parallellogic-/MalO_SAO/doc/spec_sheets/DEFCON34_SAO_MICD.pdf

# DC34 Badge SAO Electrical Spec

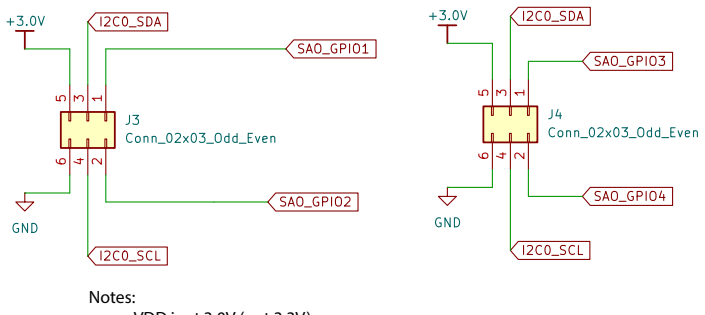
[picture p3: figure]
Notes:

# DC34 Badge SAO Mechanical Spec

- VDD is at 3.0V (not 3.3V)
- Supply tested to 100mA total across both SAOs
(supply can do “more”, but no promises)
- The badge is powered o of 2xAA batteries
- There is a USB type C port. When powered o a power bank, the badge stays continuously on
- GPIO4 is an open-drain wake-up interrupt to the CPU
- Other GPIOs have some combination of pull-up or pull-down resistors on them ranging from 2.2k to ~47k
- I2C has devices on 0x3C and 0x19

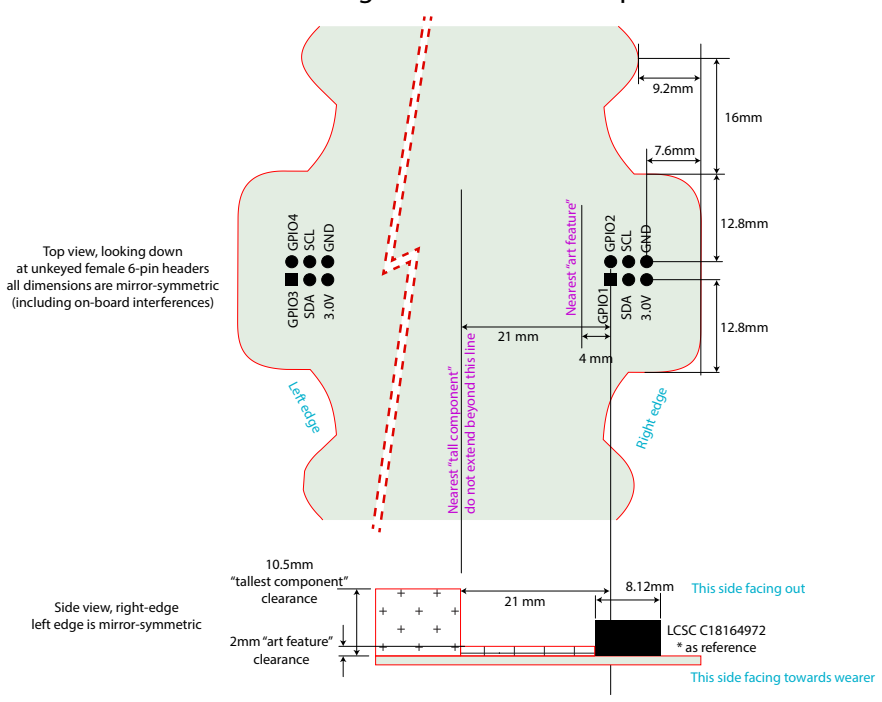
[picture p4: figure]
SCL; GND; SDA; GPIO3 GPIO4; GPIO1; GPIO2; Right edge; Left edge; Top view, looking down at unkeyed female 6-pin headers all dimensions are mirror-symmetric (including on-board interferences); Nearest “art feature”; Nearest “tall component”; do not extend beyond this line; Side view, right-edge; left edge is mirror-symmetric; LCSC C18164972; * as reference 2mm “art feature”; clearance; 10.5mm “tallest component” clearance; This side facing out; This side facing towards wearer
