parallellogic-/MalO_SAO/doc/header.png

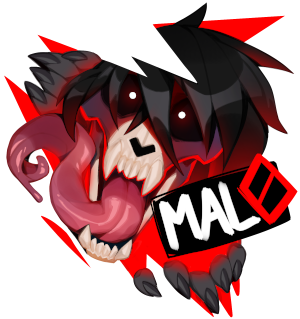
doc/header.png
