parallellogic-/MalO_SAO/doc/r2/layout_bottom.png

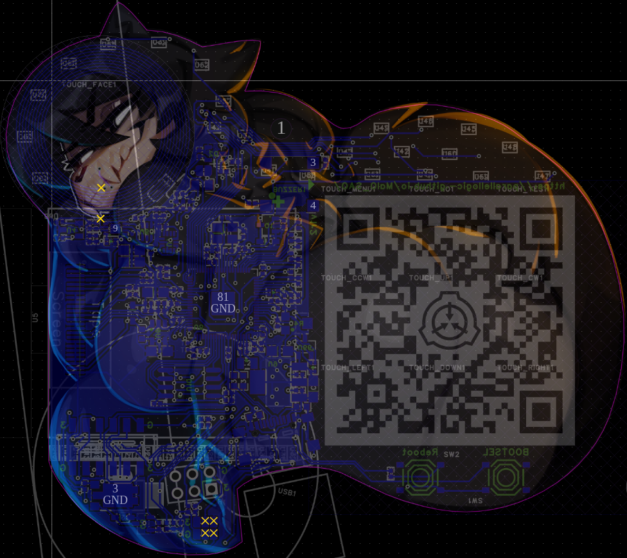
doc/r2/layout_bottom.png
