parallellogic-/MalO_SAO/doc/r2/layout_top.png

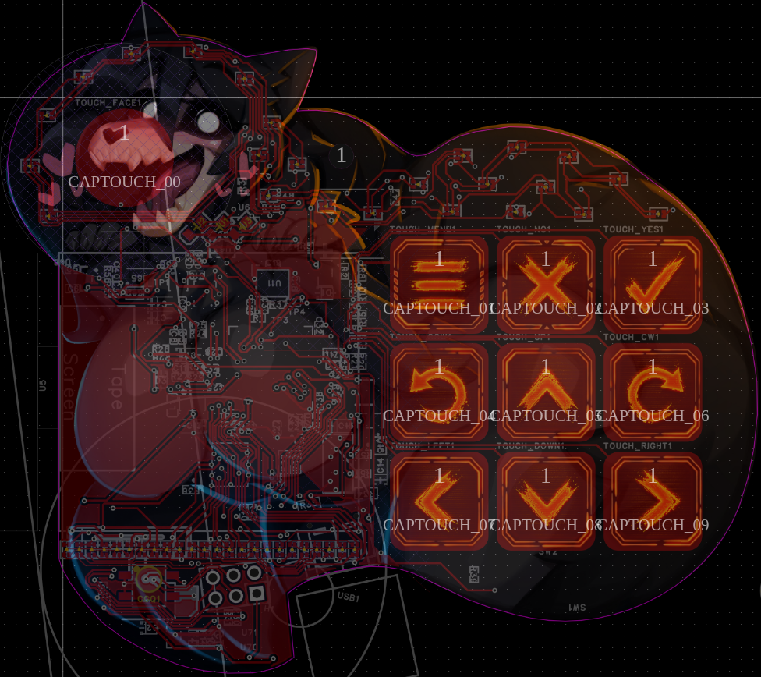
doc/r2/layout_top.png
