parallellogic-/MalO_SAO/doc/r2/render_back_ransparent.png

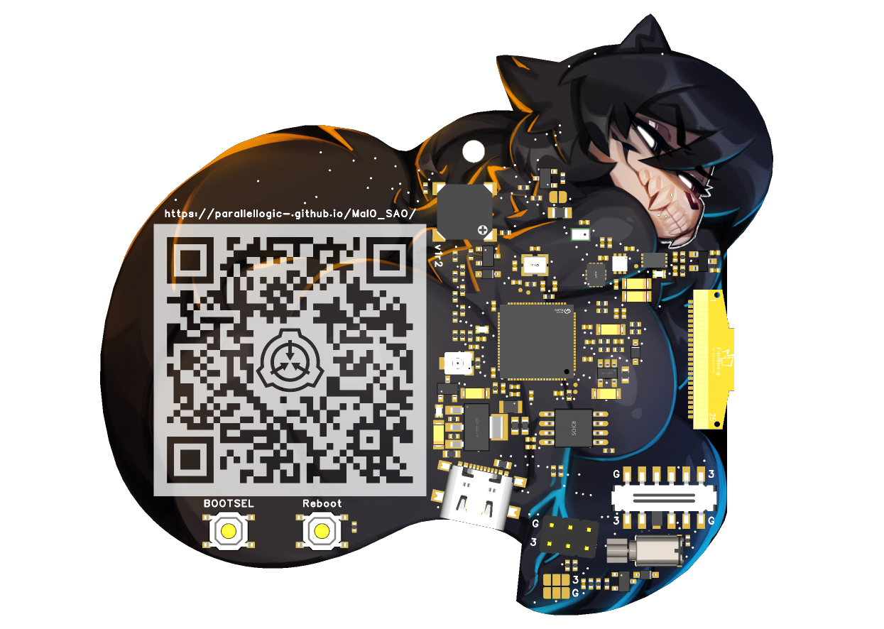
doc/r2/render_back_ransparent.png
