parallellogic-/MalO_SAO/doc/r2/render_front_dims.png

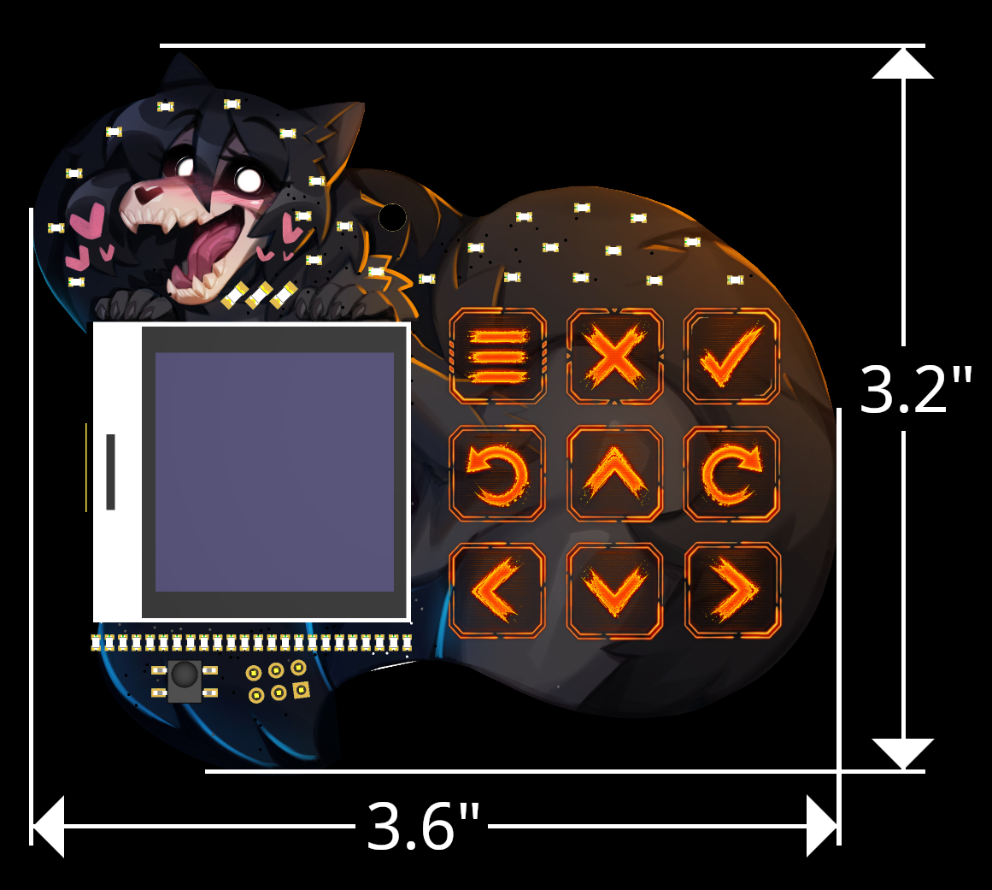
doc/r2/render_front_dims.png
