parallellogic-/MalO_SAO/doc/r2/render_front_transparent.png

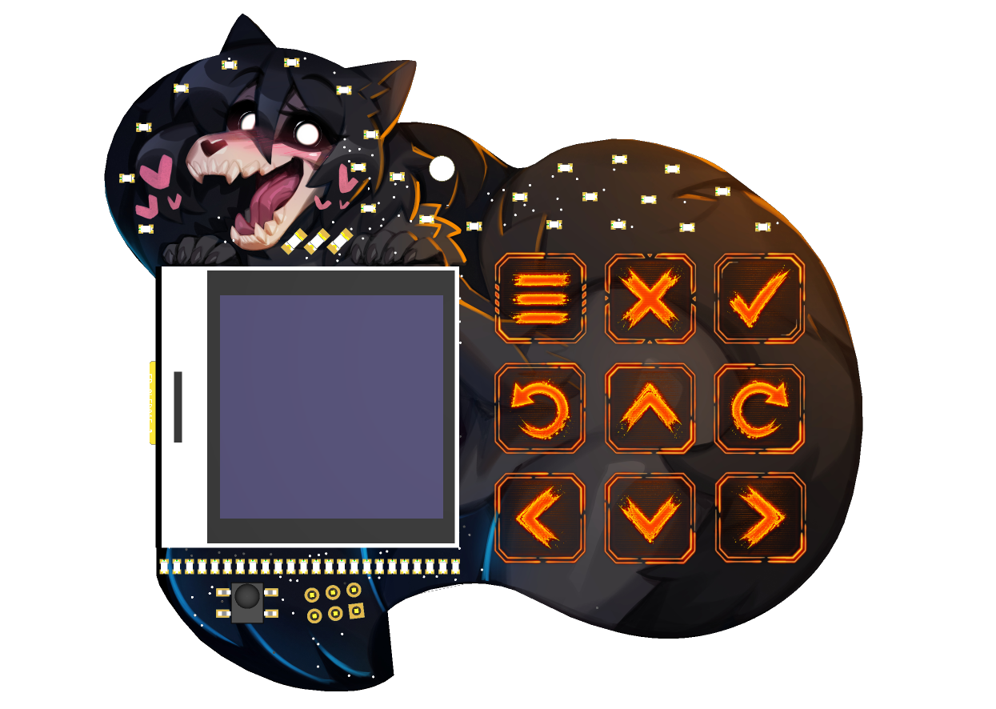
doc/r2/render_front_transparent.png
