parallellogic-/MalO_SAO/doc/r2/render_side.png

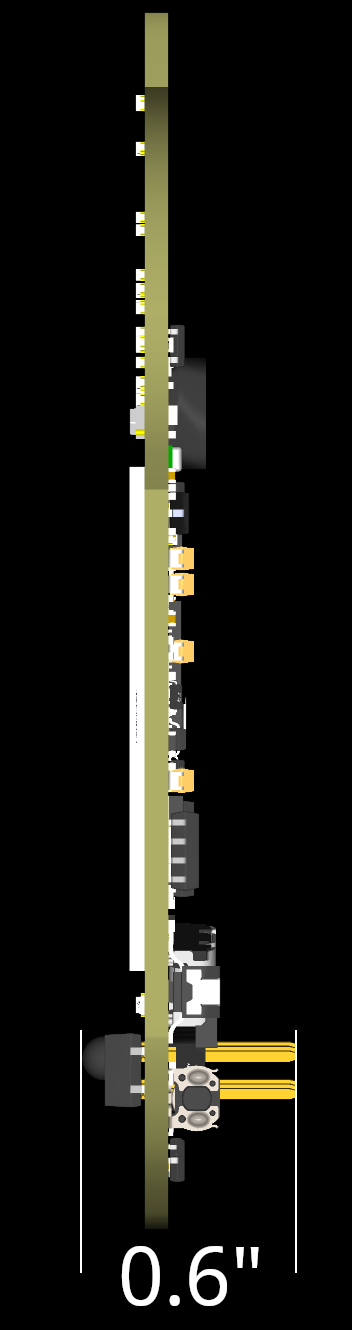
doc/r2/render_side.png
