parallellogic-/MalO_SAO/img/r1/art_outline.jpg

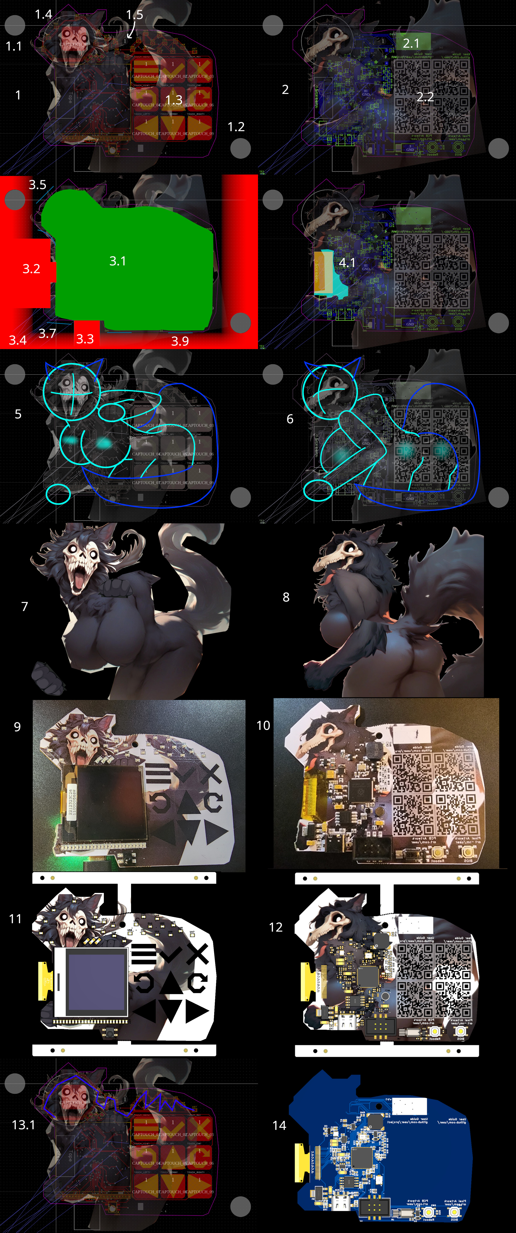
img/r1/art_outline.jpg
