parallellogic-/MalO_SAO/img/r1/front.png

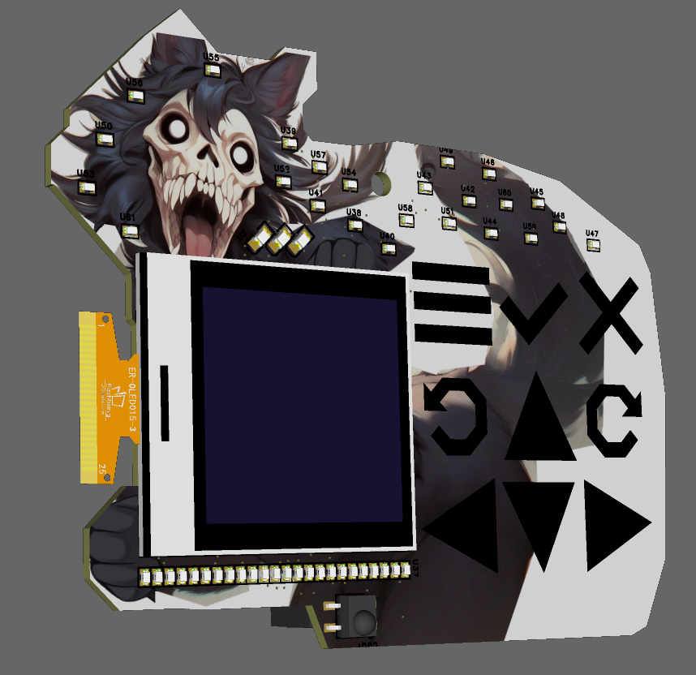
img/r1/front.png
