parallellogic-/MalO_SAO/img/r1/rear.png

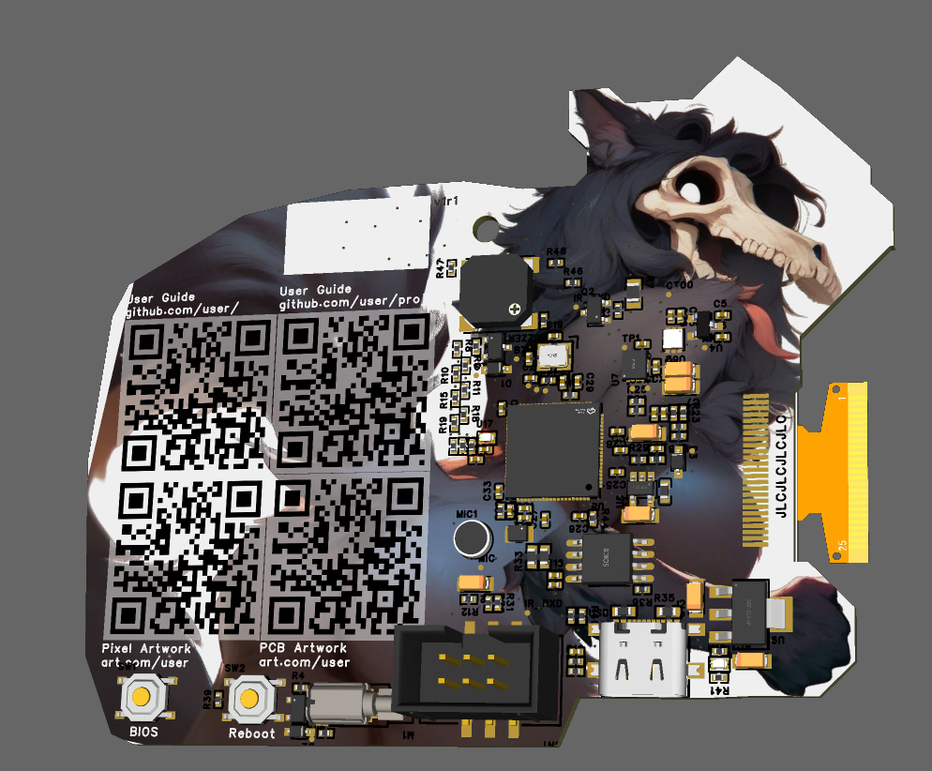
img/r1/rear.png
