parallellogic-/MalO_SAO/img/r1/Screenshot from 2026-04-02 22-24-46.png

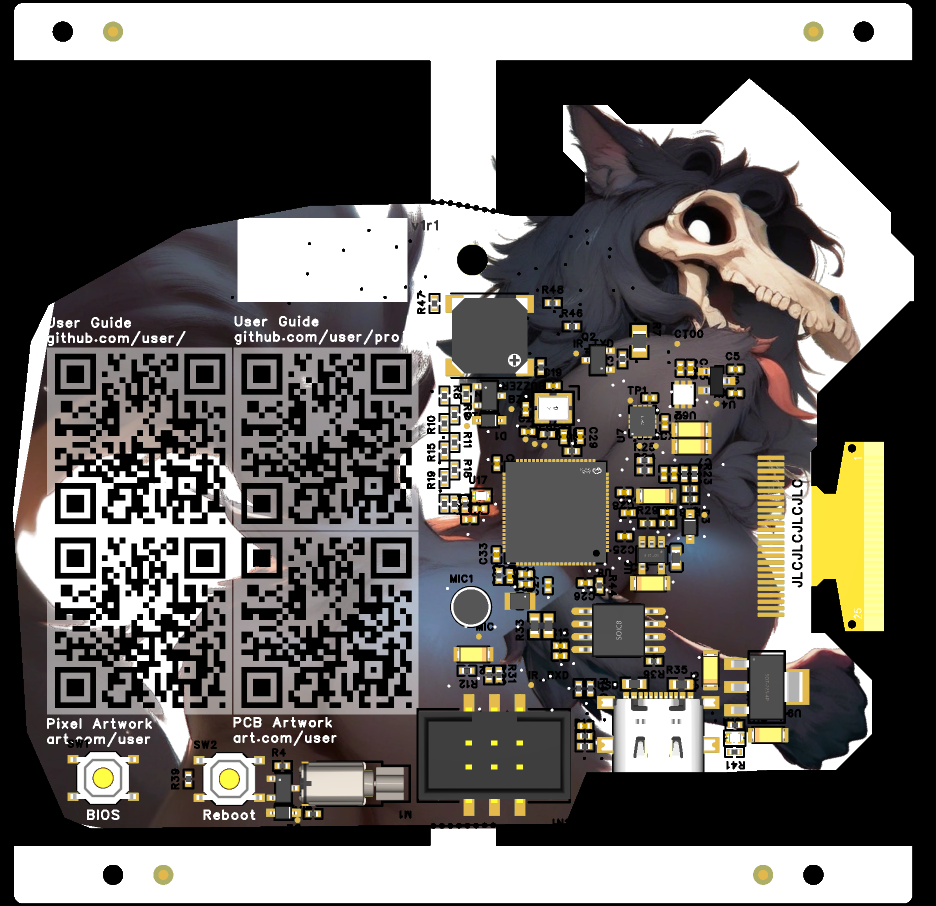
img/r1/Screenshot from 2026-04-02 22-24-46.png
