parallellogic-/MalO_SAO/img/r1/Screenshot from 2026-04-02 22-28-03.png

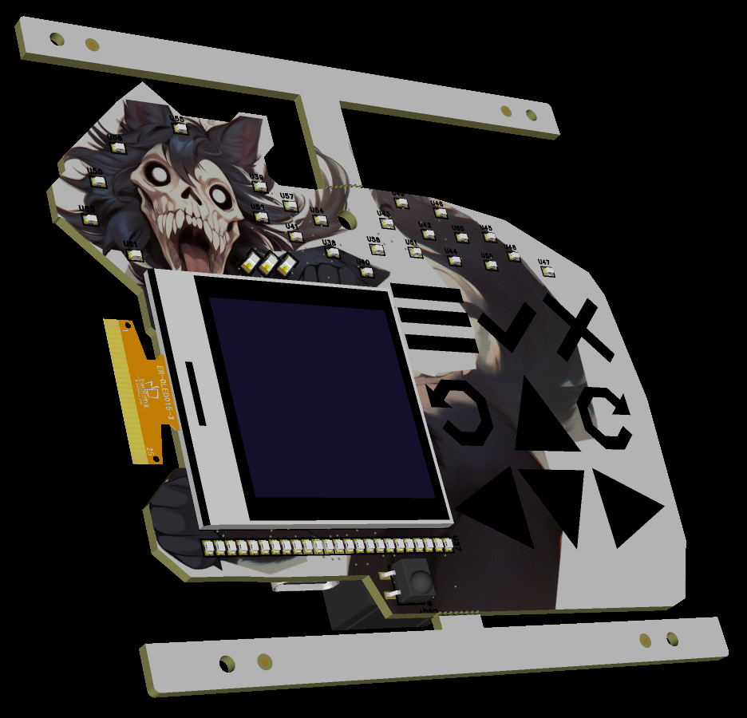
img/r1/Screenshot from 2026-04-02 22-28-03.png
