parallellogic-/MalO_SAO/img/r2/back_hotglewd.jpg

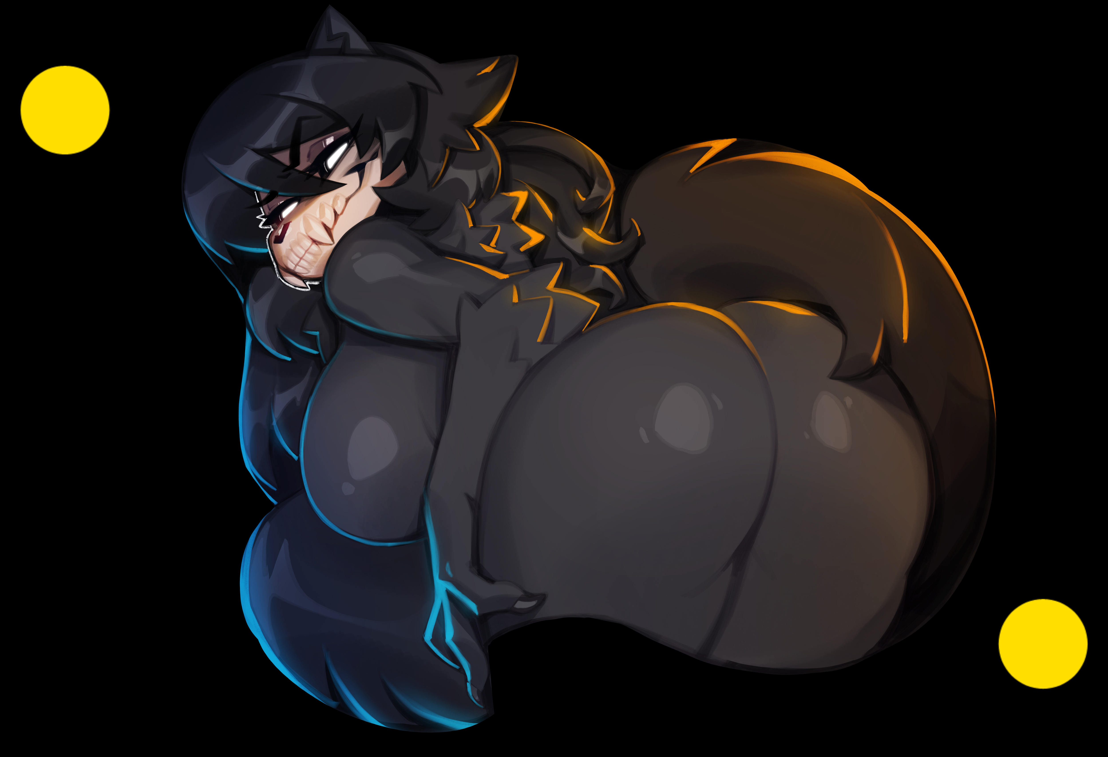
img/r2/back_hotglewd.jpg
