parallellogic-/MalO_SAO/img/r2/back_hotglewd_merged.jpg

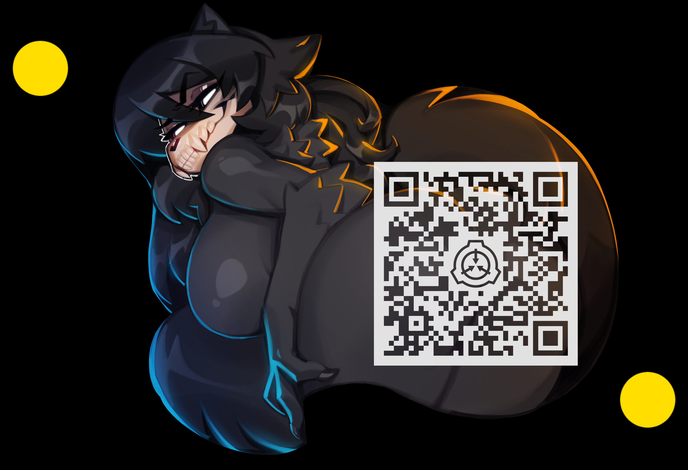
img/r2/back_hotglewd_merged.jpg
