parallellogic-/MalO_SAO/img/r2/buttons.png

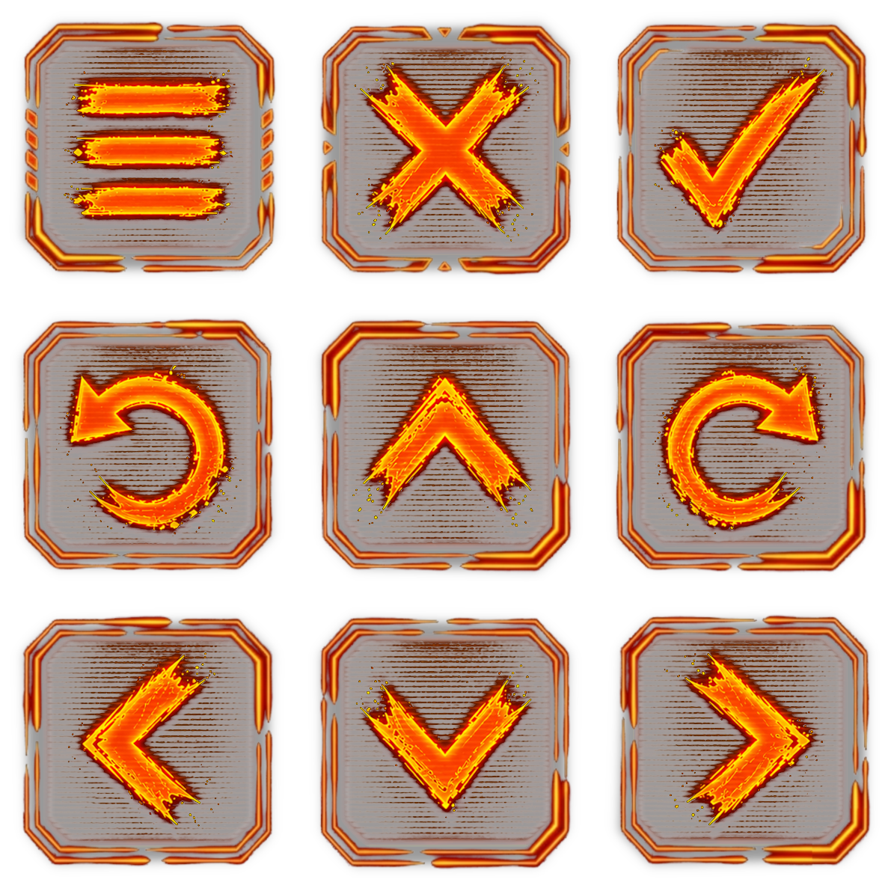
img/r2/buttons.png
