parallellogic-/MalO_SAO/img/r2/front_hotglewd.jpg

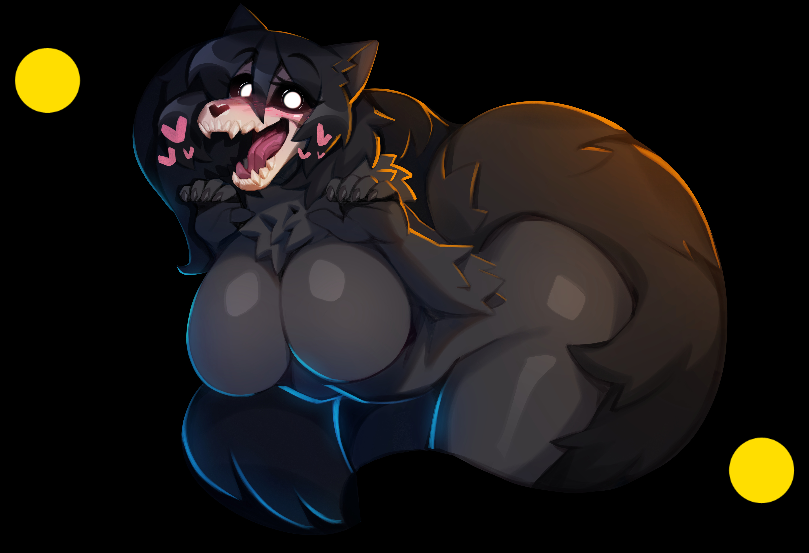
img/r2/front_hotglewd.jpg
