parallellogic-/MalO_SAO/img/stickers/back_hotglewd_merged_v3.jpg

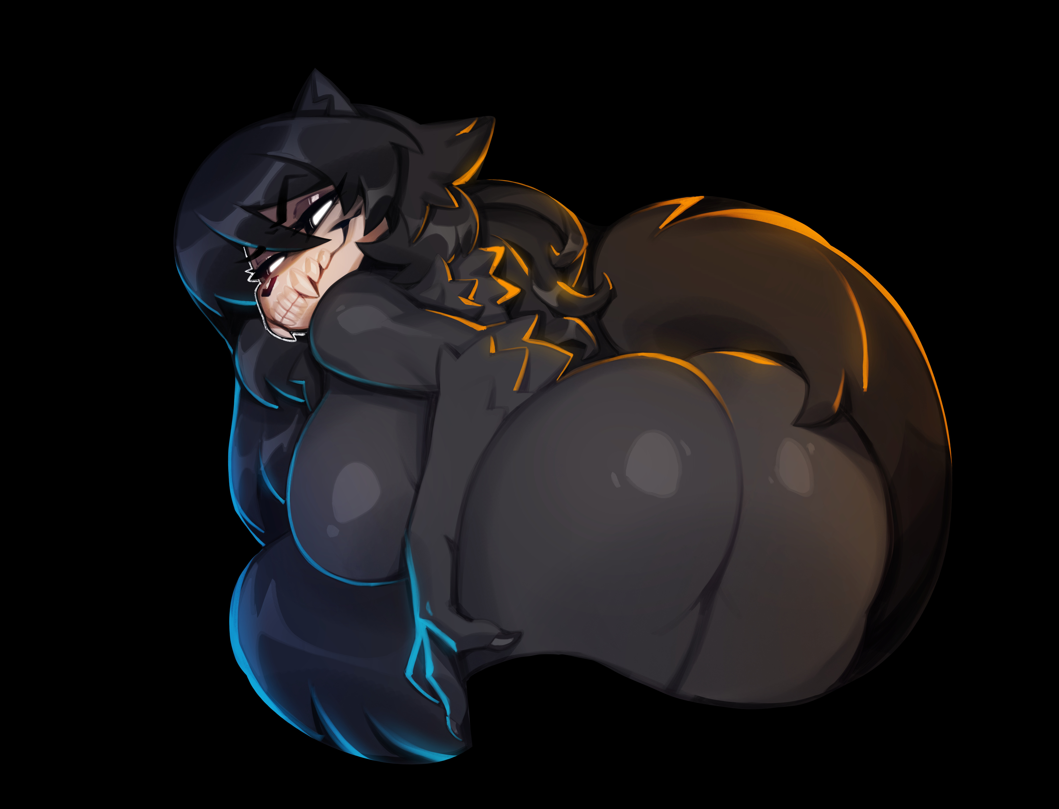
img/stickers/back_hotglewd_merged_v3.jpg
