parallellogic-/MalO_SAO/img/stickers/front_hotglewd_merged_v3.jpg

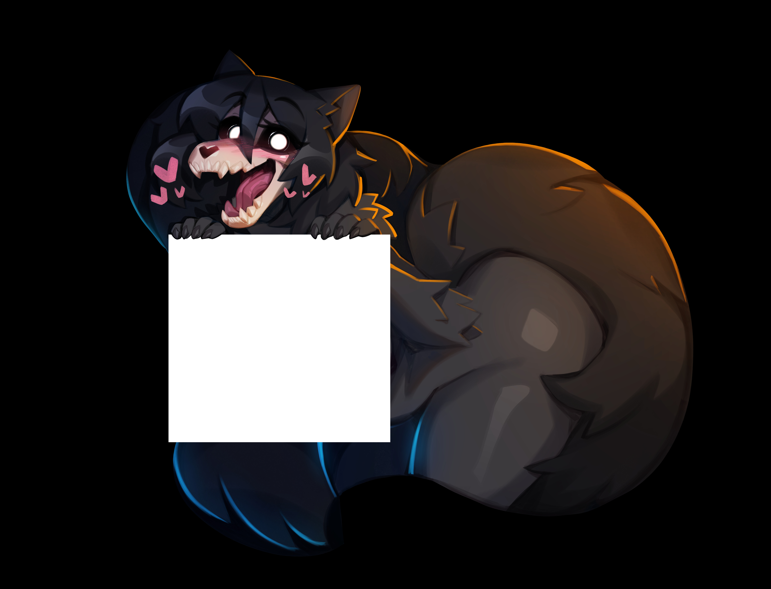
img/stickers/front_hotglewd_merged_v3.jpg
