parallellogic-/MalO_SAO/fab/r3/BOM_Board1_PCB1_2026-06-30.csv

No. | Quantity | Comment | Designator | Footprint | Value | Manufacturer Part | Manufacturer | Supplier Part | Supplier
1 | 1 | 2.7kHz | BUZZER1 | BUZ-SMD_4P-L7.5-W7.5-P7.59-TL | 2.7kHz | MLT-7525 | 华能 | C95299 | LCSC
2 | 1 | 2.2uF | C1 | C0402 | 2.2uF | CL05A225KP5NSNC | SAMSUNG(三星) | C107369 | LCSC
3 | 11 | 100nF | C3,C5,C6,C8,C9,C10,C11,C16,C35,C37,C38 | C0402 | 100nF | CL05B104KB54PNC | SAMSUNG(三星) | C307331 | LCSC
4 | 5 | 10uF | C4,C7,C12,C13,C14 | CASE-A_3216 | 10uF | CA45-A010K106T | 湘怡中元/湘江 | C119052 | LCSC
5 | 1 | 22uF | C15 | CASE-A_3216 | 22uF | CA45-A-10V-22uF-K | CEC(振华新云) | C129272 | LCSC
6 | 2 | 4.7uF | C17,C36 | C0402 | 4.7uF | CL05A475KP5NRNC | SAMSUNG(三星) | C368809 | LCSC
7 | 2 | 15pF | C18,C19 | C0402 | 15pF | 0402CG150J500NT | FH(风华) | C1548 | LCSC
8 | 4 | 4.7uF | C20,C21,C22,C34 | C0402 | 4.7uF | CL05A475MP5NRNC | SAMSUNG(三星) | C23733 | LCSC
9 | 11 | 100nF | C23,C24,C25,C26,C27,C28,C29,C30,C31,C32,C33 | C0402 | 100nF | CL05A104KA5NNNC | SAMSUNG(三星) | C100072 | LCSC
10 | 2 | 22pF | C39,C40 | C0402 | 22pF | 0402CG220F500NT | FH(风华) | C190090 | LCSC
11 | 1 | IRM-H638T/TR2 | CGQ1 | SENSOR-SMD_IRM-H638T-TR2-TL |  | IRM-H638T/TR2 | EVERLIGHT(亿光) | C91447 | LCSC
12 | 3 | 1N5819WS | D1,D2,D3 | SOD-323_L1.8-W1.3-LS2.5-RD |  | 1N5819WS | Hottech(合科泰) | C191023 | LCSC
13 | 1 | PZ254V-12-6P | H1 | HDR-TH_6P-P2.54-V-M-R2-C3-S2.54 |  | PZ254V-12-6P | XFCN(兴飞) | C492420 | LCSC
14 | 1 | 10uH | L1 | L0603 | 10uH | SDFL1608S100KTF | Sunlord(顺络) | C1035 | LCSC
15 | 1 | 3.3uH | L2 | IND-SMD_L2.0-W1.6_AOTA-B201610S3R3-101-T | 3.3uH | AOTA-B201610S3R3-101-T | ABRACON | C42411119 | LCSC
16 | 1 | Z3OC1T8219731 | M1 | VIBRATING-MOTOR-SMD_3P-C9900001680 |  | Z3OC1T8219731 | KOTL(金龙机电) | C2894731 | LCSC
17 | 3 | L2N7002SLLT1G | Q1,Q2,Q3 | SOT-23-3_L3.0-W1.7-P0.95-LS2.9-BR |  | L2N7002SLLT1G | LRC(乐山无线电) | C22446827 | LCSC
18 | 10 | 1MΩ | R1,R8,R9,R10,R11,R15,R18,R19,R20,R21 | R0402 | 1MΩ | FRC0402F1004TS | FOJAN(富捷) | C2909328 | LCSC
19 | 7 | 10kΩ | R2,R3,R4,R28,R29,R52,R53 | R0402 | 10kΩ | FRC0402J103 TS | FOJAN(富捷) | C2906885 | LCSC
20 | 1 | 0Ω | R5 | R0402 | 0Ω | FRC0402P000 TS | FOJAN(富捷) | C2906877 | LCSC
21 | 1 | 5.1Ω | R6 | R0402 | 5.1Ω | FRC0402F5R10TS | FOJAN(富捷) | C2909363 | LCSC
22 | 1 | 22Ω | R7 | R0805 | 22Ω | AC0805FR-7W22RL | YAGEO(国巨) | C6492135 | LCSC
23 | 1 | 200Ω | R14 | R0402 | 200Ω | FRC0402F2000TS | FOJAN(富捷) | C2909333 | LCSC
24 | 2 | 2.2kΩ | R24,R25 | R0402 | 2.2kΩ | FRC0402J222 TS | FOJAN(富捷) | C2906920 | LCSC
25 | 1 | 1MΩ | R26 | R0402 | 1MΩ | 0402WGF1004TCE | UNI-ROYAL(厚声) | C26083 | LCSC
26 | 1 | 100kΩ | R27 | R0402 | 100kΩ | FRC0402J104 TS | FOJAN(富捷) | C2906883 | LCSC
27 | 5 | 1kΩ | R30,R31,R36,R37,R39 | R0402 | 1kΩ | FRC0402F1001TS | FOJAN(富捷) | C2906864 | LCSC
28 | 2 | 27Ω | R32,R33 | R0603 | 27Ω | 0603WAF270JT5E | UNI-ROYAL(厚声) | C25190 | LCSC
29 | 2 | 5.1kΩ | R34,R35 | R0603 | 5.1kΩ | FRC0603F5101TS | FOJAN(富捷) | C2907044 | LCSC
30 | 1 | 33Ω | R38 | R0402 | 33Ω | FRC0402F33R0TS | FOJAN(富捷) | C2906868 | LCSC
31 | 7 | 36Ω | R40,R43,R44,R45,R46,R47,R48 | R0402 | 36Ω | FRC0402F36R0TS | FOJAN(富捷) | C2998152 | LCSC
32 | 1 | 10kΩ | R49 | RES-ADJ-SMD_3P-L3.0-W3.8-P1.75-BR | 10kΩ | TC33X-2-103E | BOURNS | C719176 | LCSC
33 | 1 | 2kΩ | R51 | R0402 | 2kΩ | FRC0402F2001TS | FOJAN(富捷) | C2909344 | LCSC
34 | 2 | 6.2Ω | R55,R56 | R0402 | 6.2Ω | GR0402F6R2TAG00 | GiantOhm(鼎声微电) | C49654638 | LCSC
35 | 2 | TS-1187A-B-A-B | SW1,SW2 | SW-SMD_4P-L5.1-W5.1-P3.70-LS6.5-TL_H1.5 |  | TS-1187A-B-A-B | XKB Connection(中国星坤) | C318884 | LCSC
36 | 1 | K3-2268S-F1 | SW3 | SW-TH_K3-2268S-F1 |  | K3-2268S-F1 | 韩国韩荣 | C223866 | LCSC
37 | 10 | Test-Point | TOUCH_CCW1,TOUCH_CW1,TOUCH_DOWN1,TOUCH_FACE1,TOUCH_LEFT1,TOUCH_MENU1,TOUCH_NO1,TOUCH_RIGHT1,TOUCH_UP1,TOUCH_YES1 | touch_12mm
38 | 5 | Test-Point | TP1,TP3,TP4,TP5,TP6 | Test-Point-0.5mm
39 | 3 | XL-2012IRC-940 | U1,U2,U3 | LED0805-RD |  | XL-2012IRC-940 | XINGLIGHT(成兴光) | C965889 | LCSC
40 | 1 | HAL403SO | U4 | SOT-23-3_L2.9-W1.3-P1.90-LS2.4-BR-CW |  | HAL403SO | Hallwee(霍尔微电子) | C42387470 | LCSC
41 | 1 | SSD1327_128x128 | U5 | ssd1327_128x128
42 | 1 | MT3540-F23 | U6 | SOT-23-5_L3.0-W1.7-P0.95-LS2.8-BR |  | MT3540-F23 | 西安航天民芯 | C181783 | LCSC
43 | 1 | LSM6DS3TR | U7 | LGA-14_L3.0-W2.5-P0.50-TL |  | LSM6DS3TR | ST(意法半导体) | C95230 | LCSC
44 | 1 | RP2350B | U8 | QFN-80_L10.0-W10.0-P0.40-TL-EP3.4 |  | RP2350B | Raspberry Pi(树莓派) | C42415655 | LCSC
45 | 1 | LD1117-3.3 | U9 | SOT-223_L6.7-W3.5-P2.30-BR |  | LD1117-3.3 | UMW(友台半导体) | C347229 | LCSC
46 | 1 | W25Q128JVSIQ | U10 | SOIC-8_L5.3-W5.3-P1.27-LS8.0-BL |  | W25Q128JVSIQ | Winbond(华邦) | C113767 | LCSC
47 | 1 | ABM8-272-T3 | U11 | SMD3225-4P_SMD3225-4P |  | ABM8-272-T3 | ABRACON | C20625731 | LCSC
48 | 51 | XL-1608SURUGC | U12,U13,U14,U15,U16,U17,U18,U19,U20,U21,U22,U23,U24,U25,U26,U27,U28,U29,U30,U31,U32,U33,U34,U35,U36,U37,U38,U39,U40,U41,U42,U43,U44,U45,U46,U47,U48,U49,U50,U51,U52,U53,U54,U55,U56,U57,U58,U59,U60,U61,U69 | LED-SMD_4P-L1.6-W0.8-RD_1 |  | XL-1608SURUGC | XINGLIGHT(成兴光) | C5349934 | LCSC
49 | 1 | LTR-308ALS-01 | U62 | SENSOR-SMD_6P-L2.0-W2.0-P0.65-BL |  | LTR-308ALS-01 | LITEON(光宝) | C492382 | LCSC
50 | 1 | LMD2718T261-OA1 | U63 | MIC-SMD_6P-L2.8-W1.9-P0.98-TL |  | LMD2718T261-OA1 | LinkMems(聆麦声学) | C5373237 | LCSC
51 | 1 | 13.56MHz | U65 | UFDFN-8_L3.0-W2.0-P0.50-TL-EP1.4 | 13.56MHz | ST25DV04K-IER6C3 | ST(意法半导体) | C2908287 | LCSC
52 | 1 | LM385DBZ-1.2RG | U66 | SOT-23-3_L2.9-W1.6-P1.90-LS2.8-BR |  | LM385DBZ-1.2RG | HGC(深圳汉芯) | C5145284 | LCSC
53 | 1 | TYPE-C 16P QTWT | USB1 | USB-TYPE-C-SMD_TYPE-C-16P-QTWT |  | TYPE-C 16P QTWT | SHOU HAN(首韩) | C5187472 | LCSC
