parallellogic-/MalO_SAO/fab/assembly/malo_2-PartChamfer004d.step

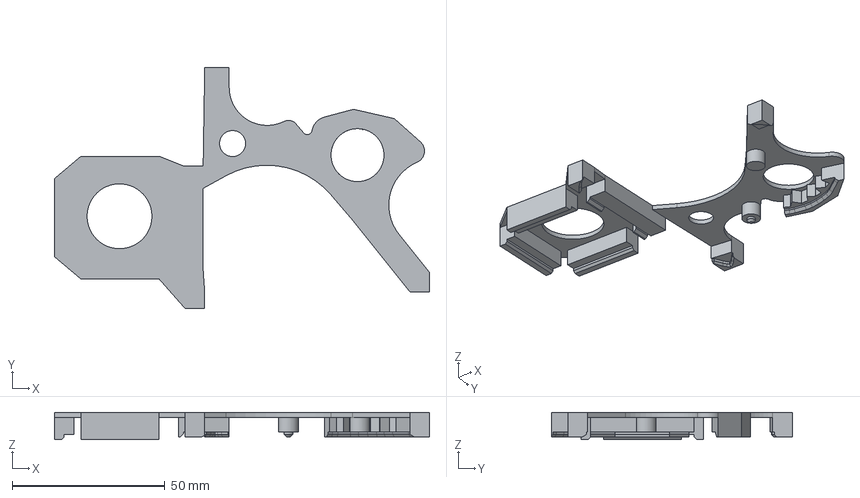
[picture p25: CAD file, 2026-07-25]
fab/assembly/malo_2-PartChamfer004d.step
122.8 x 78.8 x 8.90 mm
