parallellogic-/MalO_SAO/img/r2/outline_v3.dxf

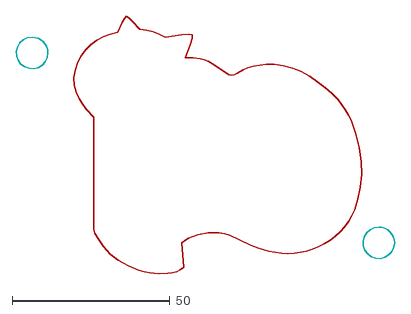
[picture p26: CAD file, 2026-06-13]
img/r2/outline_v3.dxf
120.0 x 81.6
