parallellogic-/MalO_SAO/pcb/NFC_27x27_N10_ST_ST25DV_export/NFC_26x26_N10_ST_ST25DV_geometry.dxf

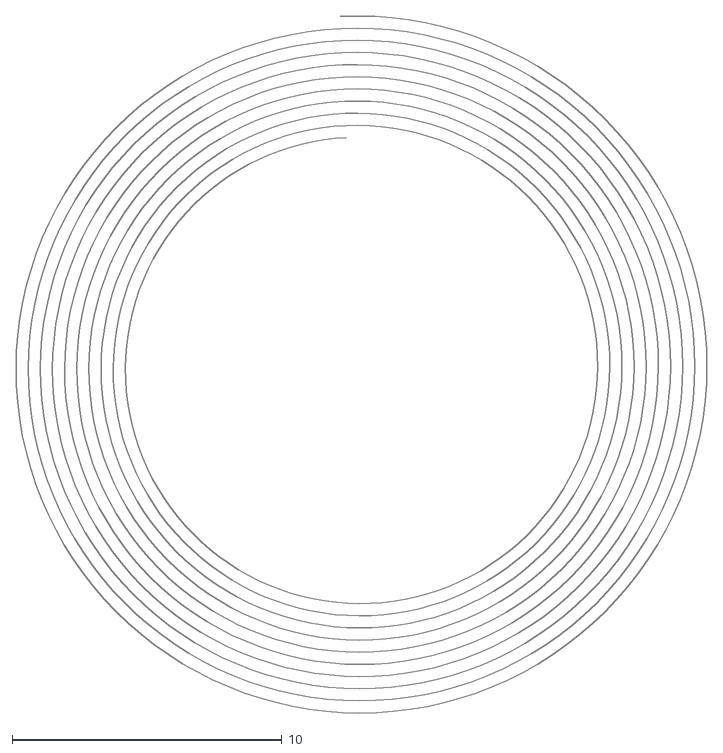
[picture p27: CAD file, 2026-06-07]
pcb/NFC_27x27_N10_ST_ST25DV_export/NFC_26x26_N10_ST_ST25DV_geometry.dxf
25.6 x 25.8
