parallellogic-/MalO_SAO/(list of files, cad)

Other CAD files:
fab/assembly/malo_2-PartChamfer004d.3mf
fab/assembly/malo_2-PartChamfer004d.stl
