parallellogic-/MalO_SAO/src/experimentation/i2c_sniff3/RigolDS0.csv

Time(s) | CH1V | CH2V
-1.220000e-04 | 3.269733e+00 | 3.284800e+00
-1.200000e-04 | 3.267467e+00 | 3.269733e+00
-1.180000e-04 | 3.265333e+00 | 3.286933e+00
-1.160000e-04 | 3.265333e+00 | 3.291200e+00
-1.140000e-04 | 3.282933e+00 | 3.284800e+00
-1.120000e-04 | 3.258667e+00 | 3.304000e+00
-1.100000e-04 | 3.254267e+00 | 3.291200e+00
-1.080000e-04 | 3.294000e+00 | 3.291200e+00
-1.060000e-04 | 3.258667e+00 | 3.299733e+00
-1.040000e-04 | 3.280800e+00 | 3.280533e+00
-1.020000e-04 | 3.256400e+00 | 3.276133e+00
-1.000000e-04 | 3.274133e+00 | 3.289067e+00
-9.800000e-05 | 3.263067e+00 | 3.295467e+00
-9.600000e-05 | 3.256400e+00 | 3.295467e+00
-9.400000e-05 | 3.267467e+00 | 3.289067e+00
-9.200000e-05 | 3.278533e+00 | 3.269733e+00
-9.000000e-05 | 3.291733e+00 | 3.280533e+00
-8.800000e-05 | 3.260800e+00 | 3.289067e+00
-8.600000e-05 | 3.274133e+00 | 3.297600e+00
-8.400000e-05 | 3.245333e+00 | 3.284800e+00
-8.200000e-05 | 3.274133e+00 | 3.291200e+00
-8.000000e-05 | 3.247600e+00 | 3.291200e+00
-7.800000e-05 | 3.256400e+00 | 3.291200e+00
-7.600000e-05 | 3.252000e+00 | 3.280533e+00
-7.400000e-05 | 3.254267e+00 | 3.284800e+00
-7.200000e-05 | 3.247600e+00 | 3.291200e+00
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
