parallellogic-/MalO_SAO/src/experimentation/i2c_sniff3/RigolDS0.ods

Time(s) | Time(s) | CH1V | CH1V | CH2V | CH2V | working | Time(s) | CH1V | CH2V | Not-working |  | CH1V | CH2V | 0.2
-0.000122 | -122 | 3.269733 | 7.269733 | 3.2848 | 3.2848 |  | -0.0003 | 3.152533 | 3.1736 | 1.5965335 | -292 | 7.352533 | 3.3736
-0.00012 | -120 | 3.267467 | 7.267467 | 3.269733 | 3.269733 |  | -0.000298 | 3.128267 | 3.158667 | 1.5966 | -290 | 7.328267 | 3.358667
-0.000118 | -118 | 3.265333 | 7.265333 | 3.286933 | 3.286933 |  | -0.000296 | 3.119333 | 3.1672 | 1.582667 | -288 | 7.319333 | 3.3672
-0.000116 | -116 | 3.265333 | 7.265333 | 3.2912 | 3.2912 |  | -0.000294 | 3.126 | 3.150133 | 1.5805335 | -286 | 7.326 | 3.350133
-0.000114 | -114 | 3.282933 | 7.282933 | 3.2848 | 3.2848 |  | -0.000292 | 3.123867 | 3.156533 | 1.5912 | -284 | 7.323867 | 3.356533
-0.000112 | -112 | 3.258667 | 7.258667 | 3.304 | 3.304 |  | -0.00029 | 3.145867 | 3.175733 | 1.5794665 | -282 | 7.345867 | 3.375733
-0.00011 | -110 | 3.254267 | 7.254267 | 3.2912 | 3.2912 |  | -0.000288 | 3.1348 | 3.165067 | 1.5794665 | -280 | 7.3348 | 3.365067
-0.000108 | -108 | 3.294 | 7.294 | 3.2912 | 3.2912 |  | -0.000286 | 3.126 | 3.156533 | 1.5816 | -278 | 7.326 | 3.356533
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
