parallellogic-/MalO_SAO/src/experimentation/combo2/RigolDS1.csv

Time(s) | CH1V | CH2V
-1.220000e-04 | 3.141467e+00 | 3.162933e+00
-1.200000e-04 | 3.145867e+00 | 3.167200e+00
-1.180000e-04 | 3.148133e+00 | 3.162933e+00
-1.160000e-04 | 3.132667e+00 | 3.148000e+00
-1.140000e-04 | 3.126000e+00 | 3.162933e+00
-1.120000e-04 | 3.152533e+00 | 3.154400e+00
-1.100000e-04 | 3.152533e+00 | 3.173600e+00
-1.080000e-04 | 3.130400e+00 | 3.148000e+00
-1.060000e-04 | 3.141467e+00 | 3.169333e+00
-1.040000e-04 | 3.128267e+00 | 3.167200e+00
-1.020000e-04 | 3.139333e+00 | 3.160800e+00
-1.000000e-04 | 3.132667e+00 | 3.156533e+00
-9.800000e-05 | 3.139333e+00 | 3.171467e+00
-9.600000e-05 | 3.150267e+00 | 3.160800e+00
-9.400000e-05 | 3.126000e+00 | 3.162933e+00
-9.200000e-05 | 3.130400e+00 | 3.152267e+00
-9.000000e-05 | 3.145867e+00 | 3.160800e+00
-8.800000e-05 | 3.156933e+00 | 3.156533e+00
-8.600000e-05 | 3.132667e+00 | 3.184267e+00
-8.400000e-05 | 3.143733e+00 | 3.169333e+00
-8.200000e-05 | 3.161333e+00 | 3.158667e+00
-8.000000e-05 | 3.132667e+00 | 3.167200e+00
-7.800000e-05 | 3.137067e+00 | 3.173600e+00
-7.600000e-05 | 3.141467e+00 | 3.162933e+00
-7.400000e-05 | 3.148133e+00 | 3.162933e+00
-7.200000e-05 | 3.137067e+00 | 3.162933e+00
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
