parallellogic-/MalO_SAO/src/experimentation/combo2/RigolDS4.csv

Time(s) | CH1V | CH2V
-3.000000e-04 | 3.152533e+00 | 3.173600e+00
-2.980000e-04 | 3.128267e+00 | 3.158667e+00
-2.960000e-04 | 3.119333e+00 | 3.167200e+00
-2.940000e-04 | 3.126000e+00 | 3.150133e+00
-2.920000e-04 | 3.123867e+00 | 3.156533e+00
-2.900000e-04 | 3.145867e+00 | 3.175733e+00
-2.880000e-04 | 3.134800e+00 | 3.165067e+00
-2.860000e-04 | 3.126000e+00 | 3.156533e+00
-2.840000e-04 | 3.152533e+00 | 3.177867e+00
-2.820000e-04 | 3.137067e+00 | 3.162933e+00
-2.800000e-04 | 3.137067e+00 | 3.152267e+00
-2.780000e-04 | 3.152533e+00 | 3.152267e+00
-2.760000e-04 | 3.132667e+00 | 3.167200e+00
-2.740000e-04 | 3.145867e+00 | 3.162933e+00
-2.720000e-04 | 3.156933e+00 | 3.150133e+00
-2.700000e-04 | 3.141467e+00 | 3.154400e+00
-2.680000e-04 | 3.137067e+00 | 3.162933e+00
-2.660000e-04 | 3.137067e+00 | 3.141467e+00
-2.640000e-04 | 3.126000e+00 | 3.160800e+00
-2.620000e-04 | 3.141467e+00 | 3.150133e+00
-2.600000e-04 | 3.148133e+00 | 3.145867e+00
-2.580000e-04 | 3.148133e+00 | 3.148000e+00
-2.560000e-04 | 3.134800e+00 | 3.160800e+00
-2.540000e-04 | 3.132667e+00 | 3.156533e+00
-2.520000e-04 | 3.134800e+00 | 3.154400e+00
-2.500000e-04 | 3.130400e+00 | 3.160800e+00
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
