parallellogic-/MalO_SAO/doc/r2/schematic.pdf

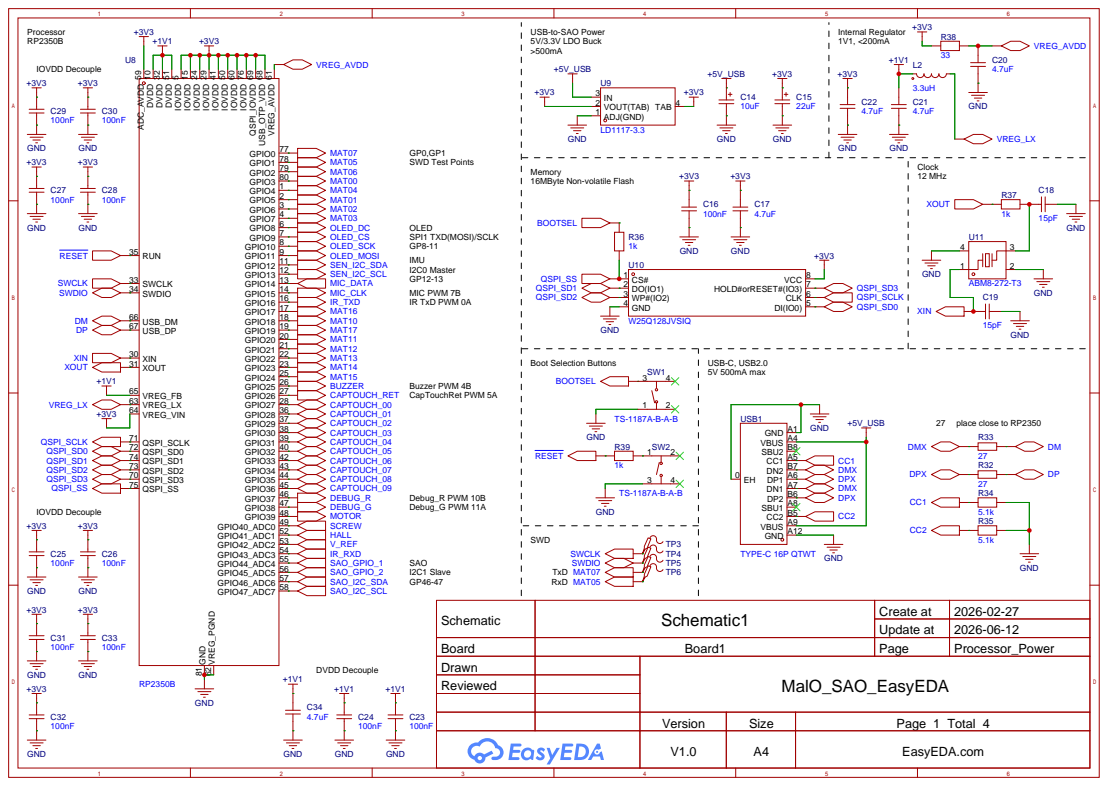
[picture p31: page 1]

Schematic | Schematic1 | Create at | 2026-02-27

Update at | 2026-06-12

Board | Board1 | Page | Processor_Power
Drawn | | MalO_SAO_EasyEDA
Reviewed

Version | Size | Page 1 Total 4
V1.0 | A4 | EasyEDA.com

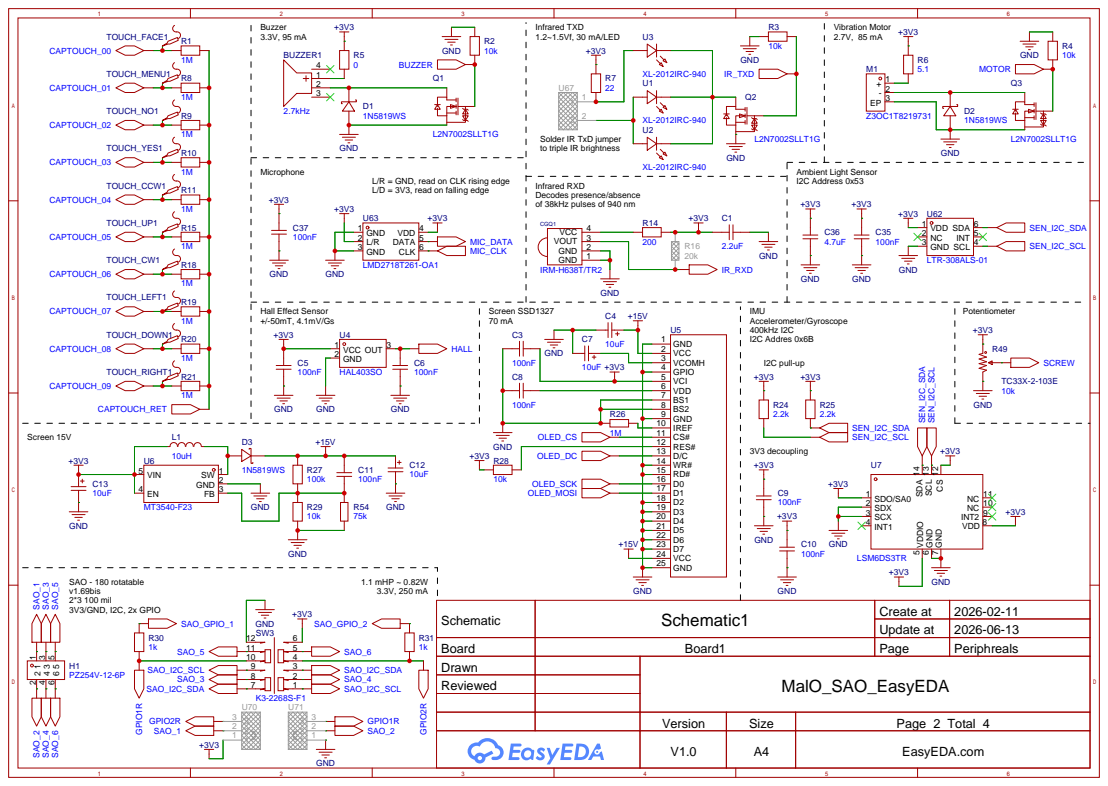
[picture p32: page 2]

L/R = GND, read on CLK rising edge
L/D = 3V3, read on falling edge

Infrared RXD
Decodes presence/absence
of 38kHz pulses of 940 nm

Schematic | Schematic1 | Create at | 2026-02-11

Update at | 2026-06-13

Board | Board1 | Page | Periphreals
Drawn | | MalO_SAO_EasyEDA
Reviewed

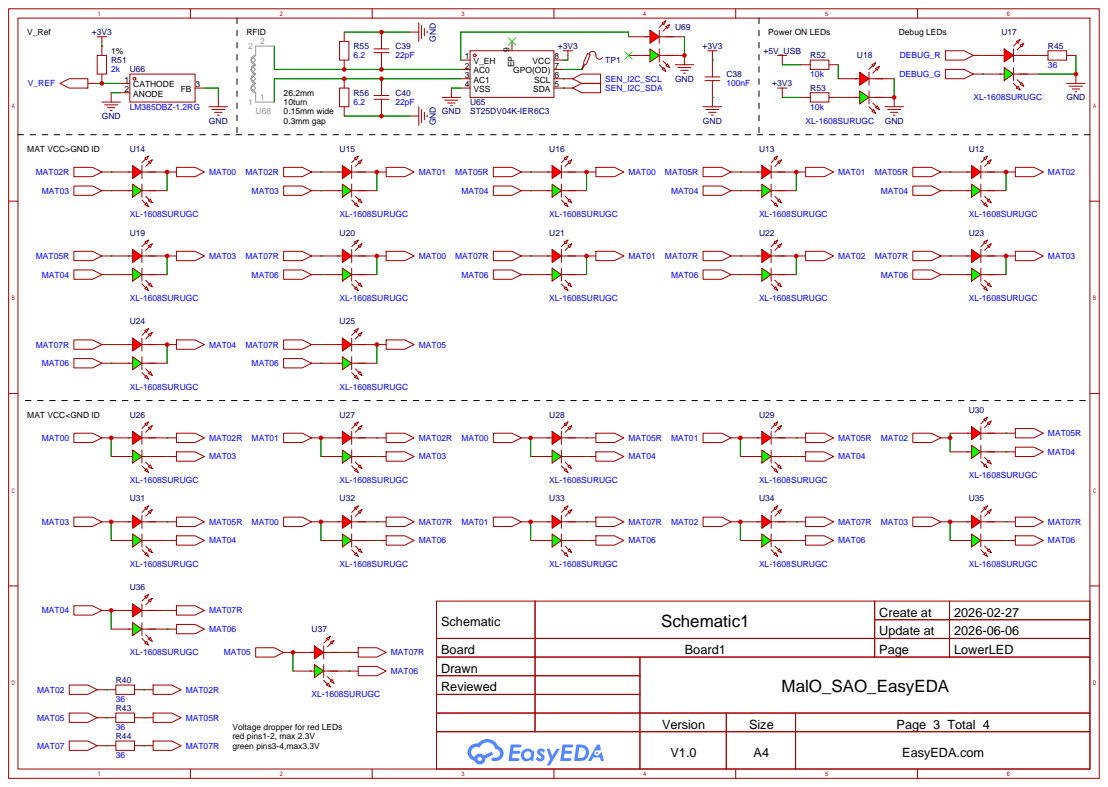
[picture p33: page 3]

MAT VCC>GND ID

MAT VCC<GND ID

Schematic | Schematic1 | Create at | 2026-02-27

Update at | 2026-06-06

Board | Board1 | Page | LowerLED
Drawn | | MalO_SAO_EasyEDA
Reviewed

Voltage dropper for red LEDs
red pins1-2, max 2.3V
green pins3-4,max3.3V

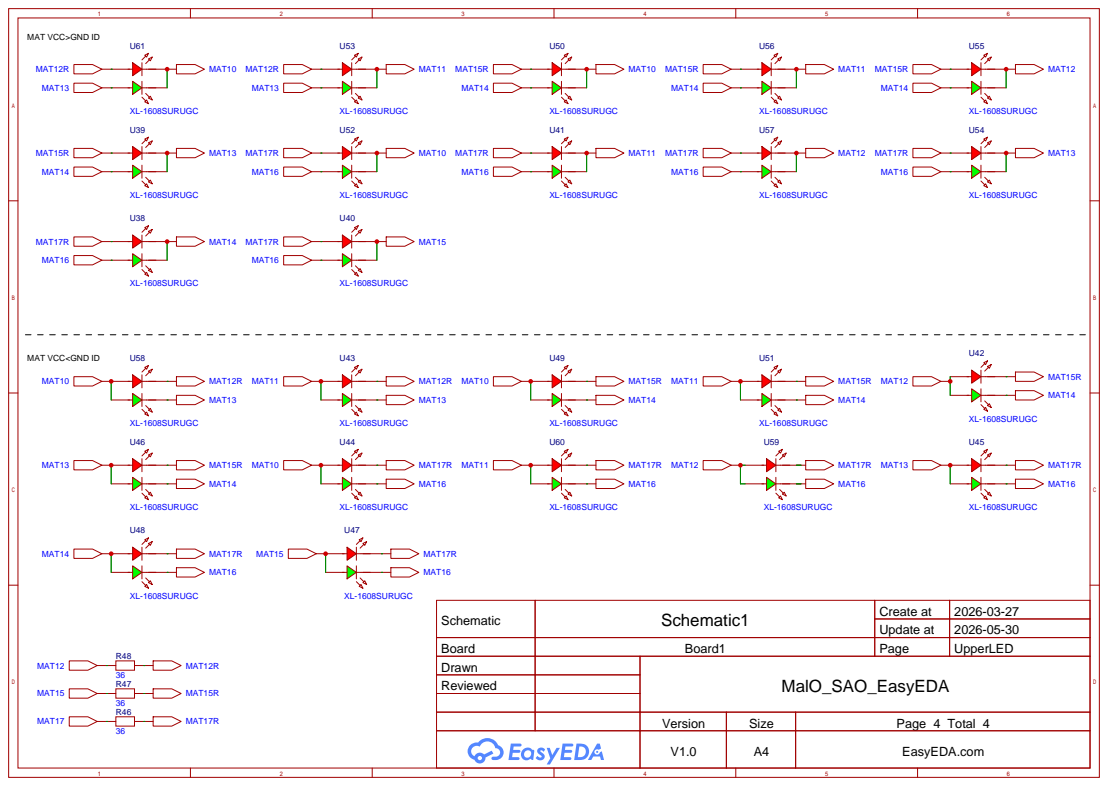
[picture p34: page 4]

MAT VCC>GND ID

MAT VCC<GND ID

Schematic | Schematic1 | Create at | 2026-03-27

Update at | 2026-05-30

Board | Board1 | Page | UpperLED
Drawn | | MalO_SAO_EasyEDA
Reviewed
