parallellogic-/MalO_SAO/doc/r1/schematic.pdf

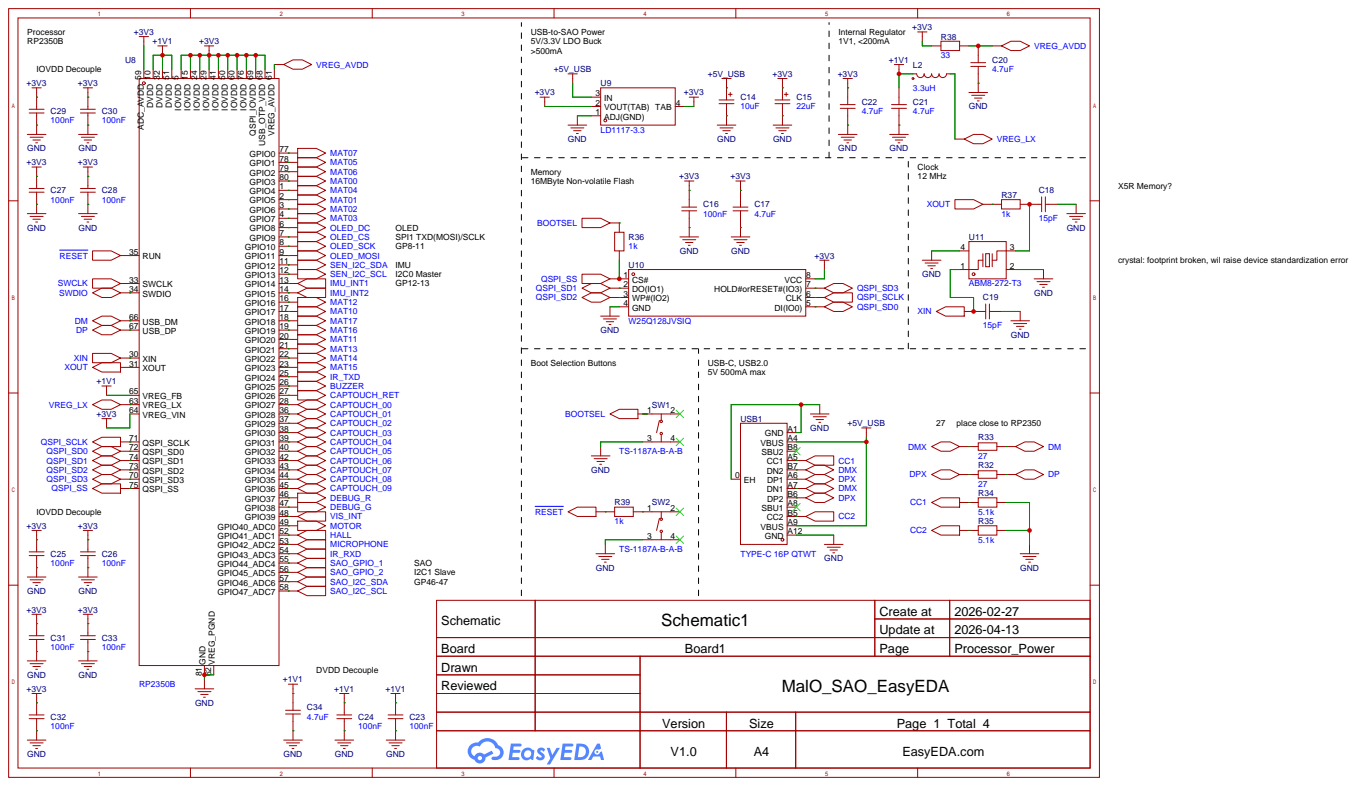
[picture p35: page 1]

crystal: footprint broken, wil raise device standardization error

Schematic | Schematic1 | Create at | 2026-02-27

Update at | 2026-04-13

Board | Board1 | Page | Processor_Power
Drawn | | MalO_SAO_EasyEDA
Reviewed

Version | Size | Page 1 Total 4
V1.0 | A4 | EasyEDA.com

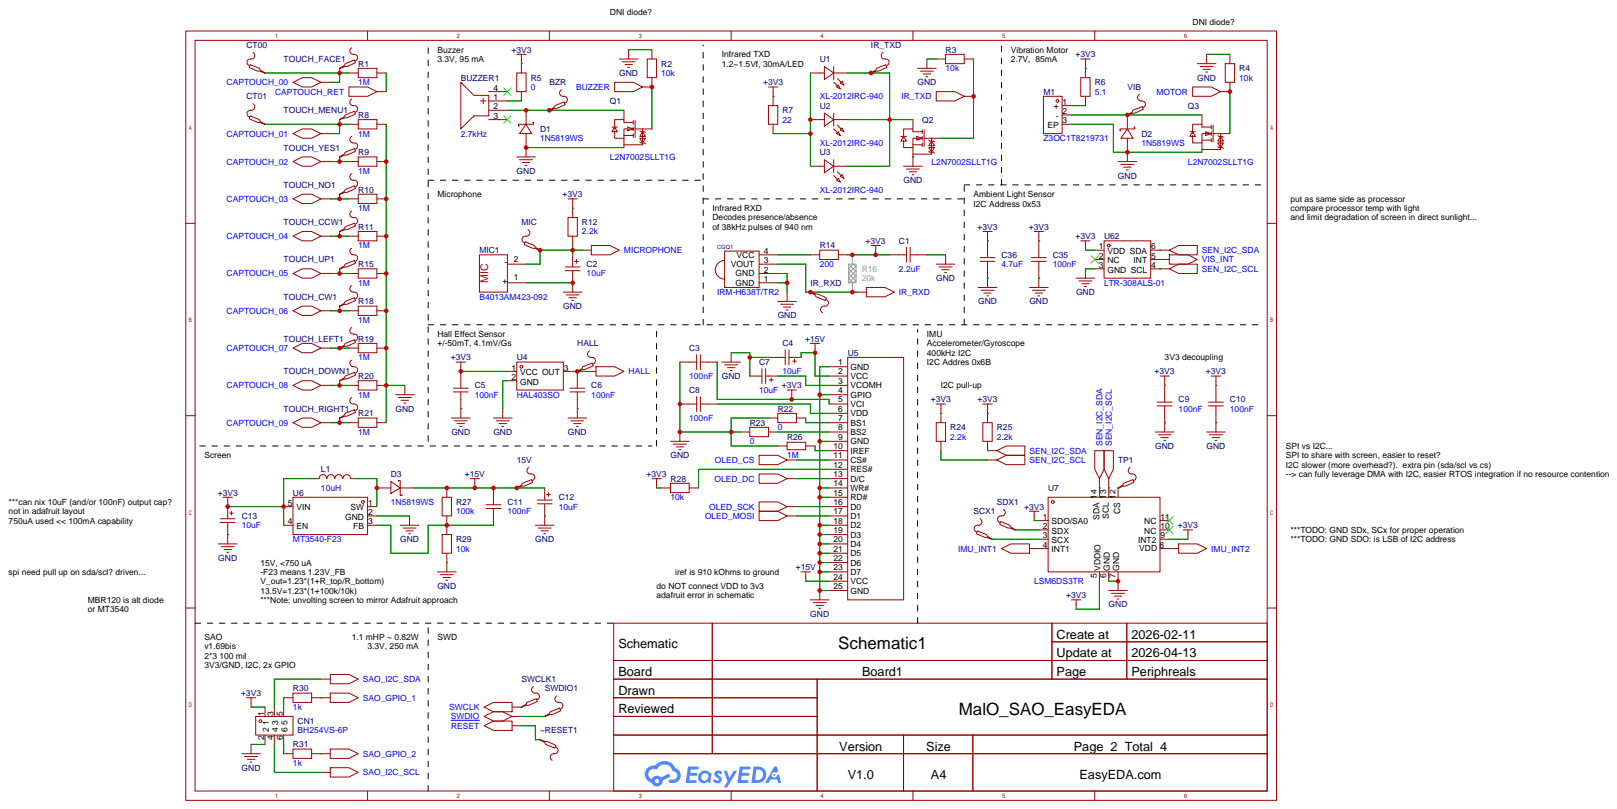
[picture p36: page 2]

put as same side as processor
compare processor temp with light
and limit degradation of screen in direct sunlight...

Infrared RXD
Decodes presence/absence
of 38kHz pulses of 940 nm

SPI vs I2C...
SPI to share with screen, easier to reset?
I2C slower (more overhead?). extra pin (sda/scl vs cs)
--> can fully leverage DMA with I2C, easier RTOS integration if no resource contention

***can nix 10uF (and/or 100nF) output cap?
not in adafruit layout
750uA used << 100mA capability

***TODO: GND SDx, SCx for proper operation
***TODO: GND SDO: is LSB of I2C address

spi need pull up on sda/scl? driven...

iref is 910 kOhms to ground
do NOT connect VDD to 3v3
adafruit error in schematic

Update at | 2026-04-13

Board | Board1 | Page | Periphreals
Drawn | | MalO_SAO_EasyEDA
Reviewed

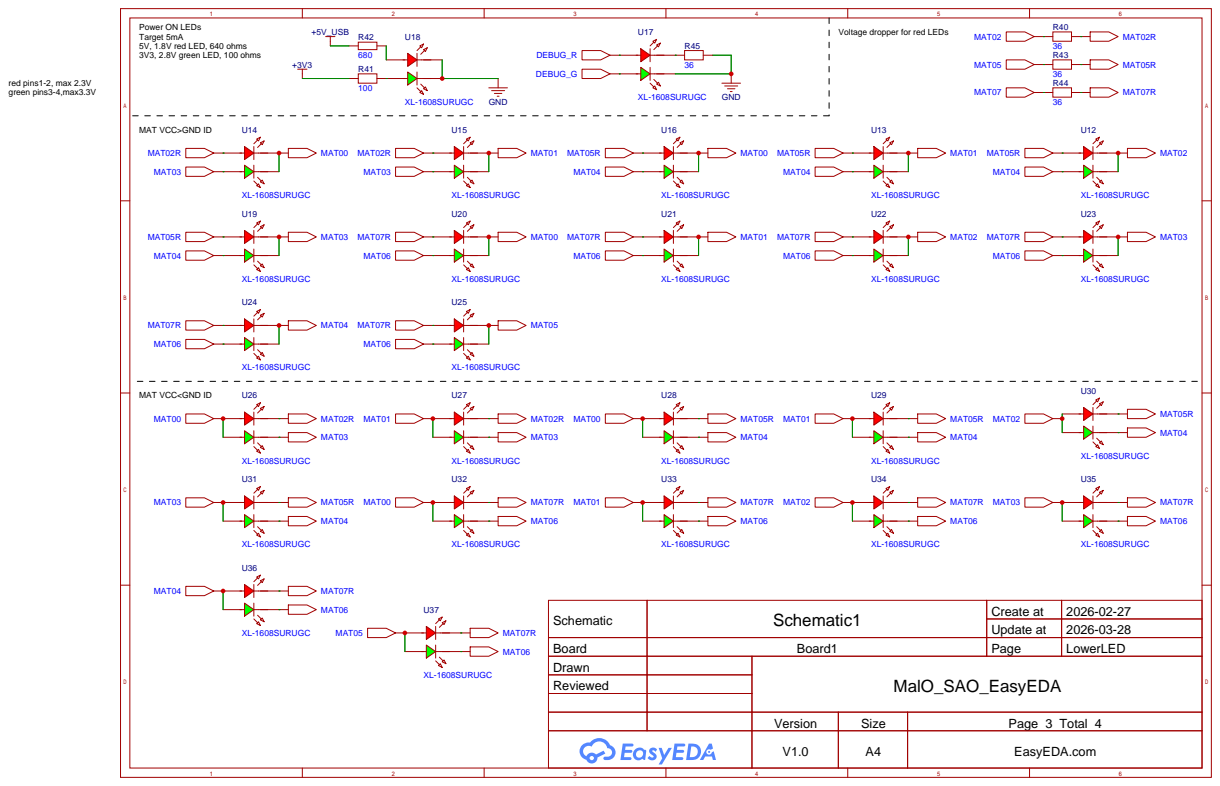
[picture p37: page 3]

Voltage dropper for red LEDs

MAT VCC>GND ID

MAT VCC<GND ID

Schematic | Schematic1 | Create at | 2026-02-27

Update at | 2026-03-28

Board | Board1 | Page | LowerLED
Drawn | | MalO_SAO_EasyEDA
Reviewed

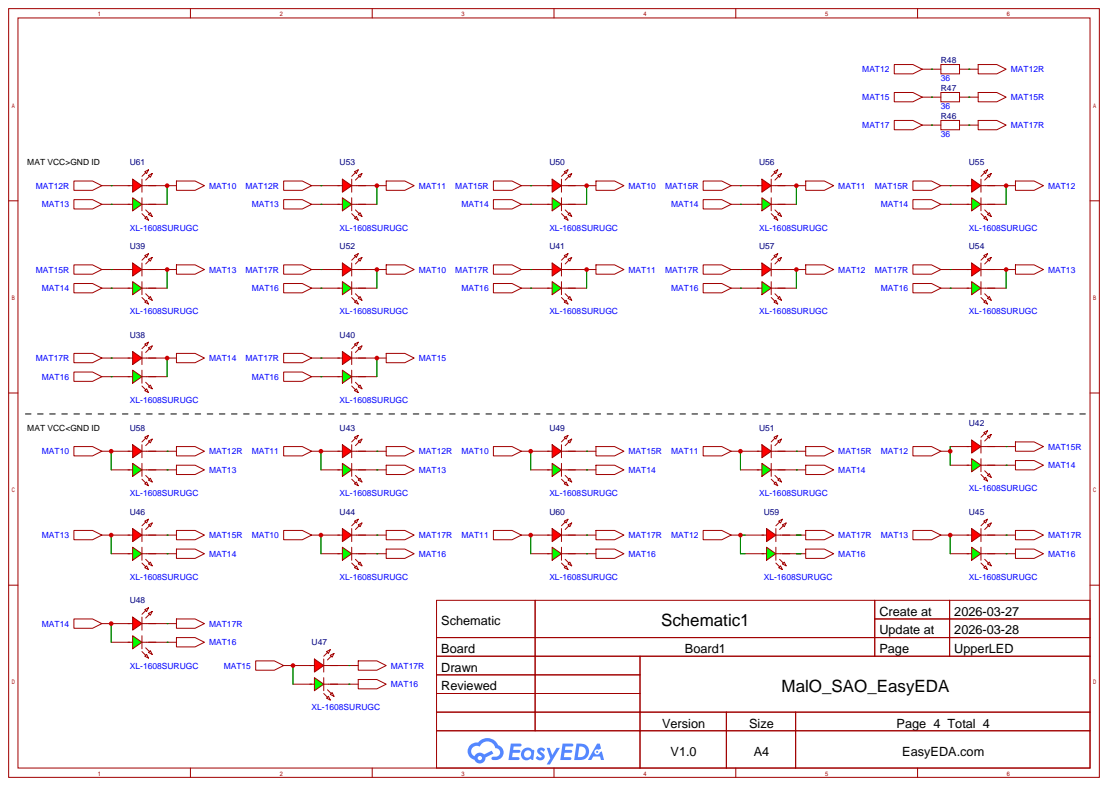
[picture p38: page 4]

MAT VCC>GND ID

MAT VCC<GND ID

Schematic | Schematic1 | Create at | 2026-03-27

Update at | 2026-03-28

Board | Board1 | Page | UpperLED
Drawn | | MalO_SAO_EasyEDA
Reviewed
