parallellogic-/MalO_SAO/(list of files, drawings)

Other design files:
pcb/MalO_SAO_EasyEDA.eprj
