parallellogic-/MalO_SAO/src/malo/led.h

#pragma once

#include <hardware/pio.h>
#include <hardware/dma.h>
#include "charlieplex.pio.h"
#include "hardware/regs/pads_bank0.h"
#include "hardware/structs/padsbank0.h"
#include "malo.h"
#include "pio_program_manager.h"
#include <string>

#define LED_UPPER_START_PIN 0
#define LED_LOWER_START_PIN 17

uint8_t const CHARLIPLEX_LED_COUNT=24*2;//24 reg-green LEDs

uint16_t const CHARLIEPLEX_PINOUT_CONFIG[2][CHARLIPLEX_LED_COUNT]={//index 0: lower LEDs config (under screen), index 1: upper LEDs (in hair)
{//lower LEDs
//red [0..23] left-to-right from led_matrix.ods.  MSB is dir (output=1, float=0), LSB is pin (1=high, 0=low)
0x6040,0x4840,0x0A02,0x2202,0x8202,0x4202,0x0901,0x2101,0x4101,0x1101,0x0301,0x8101,0x6020,0x4808,0x0A08,0x2220,0x4240,0x8280,0x8180,0x4140,0x2120,0x0908,0x1110,0x0302,

//green 24..47 left-to-right
0xA080,0x8880,0x1810,0x3010,0x9010,0x5010,0x0C04,0x2404,0x4404,0x1404,0x0604,0x8404,0xA020,0x8808,0x1808,0x3020,0x5040,0x9080,0x8480,0x4440,0x2420,0x0C08,0x1410,0x0602
},{//upper LEDs
//red CW around her face, then mostly left-to-right (and bottom-to-top along diagonals)
0x1210,0x1810,0x8280,0x8880,0x9080,0xA080,0x0604,0x1404,0x0C04,0x2404,0x4404,0x8404,0x1202,0x1808,0x8202,0x8808,0x9010,0xA020,0x0602,0x0C08,0x1410,0x2420,0x4440,0x8480,

//green
0x2220,0x2820,0x4240,0x4840,0x5040,0x6040,0x0301,0x1101,0x0901,0x2101,0x4101,0x8101,0x2202,0x2808,0x4202,0x4808,0x5010,0x6020,0x0302,0x0908,0x1110,0x2120,0x4140,0x8180
}};

    // =================================================================
    // 1. DEFINE THE POINTER-TO-MEMBER TYPE ALIAS
    // =================================================================
    // This defines 'AnimationFunc' as a pointer to a Charlieplex member function 
    // that accepts a SensorSuite reference and returns void.
struct SensorSuite;
class Charlieplex;
typedef void (Charlieplex::*AnimationFunc)(SensorSuite &);

struct AnimationMapping {
    std::string name;
    AnimationFunc func;
};

class Charlieplex{
  private:
    uint8_t _api_brightness[CHARLIPLEX_LED_COUNT];//write brightness values here for the frame currently being developed (red in lower 24 indexes, green in the upper 24)
    uint32_t _charliplex_list[2][CHARLIPLEX_LED_COUNT+1];//31..16 is brightness, 15..8 is input(0) vs output(1) for 8 pins, 7..0 is high(1) vs low(0) for 8 pins.  +1 for a sleep statement for brightness stabalization
    uint8_t _max_effective_led_count=CHARLIPLEX_LED_COUNT;//max number of LED elements that are expected to be on simultaneously: drives refresh frame rate
    uint8_t _charliplex_index = 0;//the buffer index being read from for the current DMA operation
    uint32_t* _current_list_ptr; // The "Next" list pointer
    uint8_t _pio_index=0;
    uint8_t _first_pin;
    //PIO _pio = pio0;
    //static uint _sm_offset;//only upload the PIO program once
    //uint _sm;
    int _data_chan;//dma for moving out data
    int _ctrl_chan;//dma to loop the other dma (optional: could make a 64-element dma loop, with 0 wait states at end to save a DMA channel)
  public:
    Charlieplex(bool is_upper);
    void begin(PIOProgramManager &pio_program_manager);
    void end();
    void flush();
    void set_brightness(uint8_t index,uint8_t brightness);
    void set_max_effective_led_count(uint8_t count);

    void animation_off(SensorSuite &sensor_suite);
    void animation_blink(SensorSuite &sensor_suite);
    void animation_cycle(SensorSuite &sensor_suite);
    void animation_evil(SensorSuite &sensor_suite);
    void animation_fire(SensorSuite &sensor_suite);
    void animation_gyroscope(SensorSuite &sensor_suite);
    void animation_innocent(SensorSuite &sensor_suite);
    void animation_love(SensorSuite &sensor_suite);
    void animation_menu_depth(SensorSuite &sensor_suite);
    void animation_microphone(SensorSuite &sensor_suite);
    void animation_pulse(SensorSuite &sensor_suite);
    void animation_rainbow_fade(SensorSuite &sensor_suite);
    void animation_stars(SensorSuite &sensor_suite);
    void animation_static_green(SensorSuite &sensor_suite);
    void animation_static_red(SensorSuite &sensor_suite);
    void animation_steeple_chase(SensorSuite &sensor_suite);

    static bool get_animation_by_name(const std::string name, AnimationFunc &dest_func);
    static uint8_t get_animation_count(); //{ return sizeof(animation_table) / sizeof(animation_table[0]); }
    static std::string get_animation_at(uint8_t index);
};
