parallellogic-/MalO_SAO/(commit log)

2026-03-31 about to refactor photodiode on layout
    [BOM_Board1_PCB1_2026-03-29.csv, PickAndPlace_PCB1_2026-03-29.csv]
2026-03-31 revised light sensor to i2c and added test points
    [BOM_Board1_PCB1_2026-03-30.csv, PickAndPlace_PCB1_2026-03-30.csv]
2026-04-10 56-leds 16-bit pio charlieplex
2026-04-10 drafting logic analyzer
    [led_matrix.ods]
2026-04-17 charlieplex and captouch interaction check is ok
    [led_matrix.ods]
2026-04-18 working oled
    [led_matrix.ods]
2026-05-15 patch for open drain GP0 PIO Charlieplexing issue
    [MalO_SAO_EasyEDA.eprj, led_matrix.ods]
2026-05-15 chasing 0-brighntess led
2026-05-19 img gen script
    [MalO_SAO_EasyEDA.eprj, led_matrix.ods]
2026-05-20 i2c activity
    [MalO_SAO_EasyEDA.eprj]
2026-05-20 working light sensor
2026-05-22 imu able to read
    [MalO_SAO_EasyEDA.eprj]
2026-05-22 imu troubleshooting - can get data from 0x22, but not fifo...
2026-05-23 multi-i2c working by dead-reckoning delay in between interactions to allow i2c fifo to empty
    [MalO_SAO_EasyEDA.eprj, RigolDS0.csv, RigolDS0.ods, RigolDS1.csv, RigolDS2.csv, RigolDS3.csv, RigolDS4.csv]
2026-05-23 stable build querying i2c status register with core
    [MalO_SAO_EasyEDA.eprj]
2026-05-24 need to refactor to account for imu not loop around fifo address - need to send fifo read address with every read transaction
2026-05-24 imu working model
2026-05-24 added readoperation to end of all i2c calls
2026-05-25 added dma hook to ensure good transfer
2026-05-25 needed to use Wire instead of i2c_init after damage from rework (?), this is stable
    [combo2.ino, imu.h, imu.ino]
2026-05-25 working accel and leds
2026-05-25 fixed screen boot config
    [combo2.ino]
2026-05-25 concept for DMA GPIO toggling - using master override
2026-05-26 stable dma screen build
2026-05-26 added demo of imu to screen, unclear where black bleed is coming from
2026-05-27 removed subframe concept, not enough timemargin to fit in
    [MalO_SAO_EasyEDA.eprj]
2026-05-27 stable adc build, considering adding oversampling
2026-05-30 simple oversampling by x16
    [MalO_SAO_EasyEDA.eprj]
2026-05-30 patch for INT2 on IMU
2026-05-31 reworking layout for r2
    [MalO_SAO_EasyEDA.eprj, NFC_27x27_N11_ST_ST25DV_BOM.csv, NFC_27x27_N11_ST_ST25DV_geometry.dxf]
2026-05-31 filling in spec sheet documentation
    [MalO_SAO_EasyEDA.eprj]
2026-06-07 button rework
    [NFC_26x26_N10_ST_ST25DV_BOM.csv, NFC_26x26_N10_ST_ST25DV_geometry.dxf, NFC_27x27_N11_ST_ST25DV_BOM.csv, NFC_27x27_N11_ST_ST25DV_geometry.dxf]
2026-06-07 saving pcb schanges
    [BOM_Board1_PCB1_2026-03-29.csv, PickAndPlace_PCB1_2026-03-29.csv]
2026-06-07 fixed power cap
2026-06-07 v2 pcb touchup
2026-06-07 Squashed 'src/micropython/' content from commit b5d85b670
    git-subtree-dir: src/micropython
    git-subtree-split: b5d85b670acb5cb25e617587acfef014cfe5f23b
    [MIMXRT1011_af.csv, MIMXRT1015_af.csv, MIMXRT1021_af.csv, MIMXRT1052_af.csv, MIMXRT1062_af.csv, MIMXRT1064_af.csv, MIMXRT1176_af.csv, R7FA4M1AB3CFM.csv]
2026-06-07 Squashed 'src/micropython/' content from commit af38ee165
    git-subtree-split: af38ee165f23040e4a78a19f8d8391d89d94fc4c
    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
    [MIMXRT1011_af.csv, MIMXRT1015_af.csv, MIMXRT1021_af.csv, MIMXRT1052_af.csv, MIMXRT1062_af.csv, MIMXRT1064_af.csv, MIMXRT1176_af.csv, R7FA4M1AB3CFM.csv]
2026-06-07 restructing python
    [MIMXRT1011_af.csv, MIMXRT1015_af.csv, MIMXRT1021_af.csv, MIMXRT1052_af.csv, MIMXRT1062_af.csv, MIMXRT1064_af.csv, MIMXRT1176_af.csv, R7FA4M1AB3CFM.csv]
2026-06-13 prepare for fab file gen
    [outline_v3.dxf]
2026-06-14 r2 sent to fab
    [BOM_Board1_PCB1_2026-06-13.csv, PickAndPlace_PCB1_2026_06_13.csv]
2026-06-15 first draft py inclusion as library rather than flash file
    [pins.csv]
2026-06-16 fixed dual core power cycle py and c
    [combo2.ino, main.py, malo_core.h, mpconfigboard.h]
2026-06-16 demo of leds on dual cores
2026-06-22 candidate build of soft rebooting the processor by triggering a hard reboot - only workaround found for core1 reboot issue
    [boot.py, combo2.ino, core1_api.c, core1_main.cpp, core1_main.h, debug.py, main.py]
2026-06-22 pivot away from python as too unstable and opaque
    [core1_api.c, core1_main.cpp, core1_main.h, dma_control_block.cpp, dma_control_block.h, main.py, screen.cpp, screen.h]
2026-06-25 pdm2pcm working
    [pins.csv]
2026-06-26 80 mA with screen, cut 15V jumper to get 13.5V :wq
2026-06-26 80 mA with screen, cut 15V jumper to get 13.5V
2026-06-26 charlieplex leds included without issue
    [led.h, led.ino, malo.ino, screen.h, screen.ino]
2026-06-27 draw to layer and the blit to background. next will be to remove layer and draw direct to canvas
    [led_matrix.ods]
2026-06-28 black menu wiht no responisveness to buttons
2026-06-28 imu and light sensor integrated
2026-07-03 moved to shared resource for pio/sm
    [BOM_Board1_PCB1_2026-06-30.csv, PickAndPlace_PCB1_2026_06_30.csv, led_matrix.ods]
2026-07-10 reworking lvgl library
    [messages_send.csv]
2026-07-10 menu reespond to button push
2026-07-10 fixed scroll glitch by removing return; statement in screen maanger button read callback
    [screen.h, screen.ino, screen_manager.h, screen_manager.ino, touch.h]
2026-07-11 back button works
2026-07-11 led animations working
2026-07-11 unable to detect button press
2026-07-12 drawing one pixel at a time with rect is a workaround for image draw that fails - for locked and unlcoked icon
    [malo.ino, screen.h, screen.ino]
2026-07-14 key_cb fixed in tictactoe
    [screen.h, screen_manager.ino, tictactoe.h, tictactoe.ino]
2026-07-14 added win and reset handling
    [tictactoe.h, tictactoe.ino]
2026-07-18 drafting pong, canddidate draft tic tac toe, file system problematic
    [game.h, game.ino, led.h, led.ino, pong.h, pong.ino, screen.h, screen.ino]
2026-07-19 fixing io on pipes
    [pipe.h, pipe.ino]
2026-07-20 about to refactor buzzer away from pulse chain
    [buzzer.h, dma_control_block.ino, ir_txd.h, labyrinth.ino, malo.h, malo.ino, motor.h, pulse_chain.h]
2026-07-20 ir txd
    [messages_send.csv]
2026-07-24 3d print jig
    [malo_2-PartChamfer001.3mf, malo_2-PartChamfer001.step, malo_2-PartChamfer001.stl]
2026-07-27 merging files into uf2
    [messages_send.csv]
2026-08-08 revert to known-good build
    [oled.ino, screen.h]
2026-08-16 broekn build, going to revert...
    [file_serial8.ino, malo.ino, oled.ino, screen.ino, screen_manager.ino, universal_serial_bus_flash.h, universal_serial_bus_flash.ino]
